x893/rlc-meter-balmer/README.md

# RLC-Meter-balmer
Complex impedance meter capable of measuring impedance in the range 1 mOhm - 10 MW at a frequency of 100 Hz to 250 kHz. Much attention is paid to measurement accuracy. Accuracy of better than 0.5% in the range 10 ohms - 100 ohms at frequencies of 100 Hz - 100 kHz.
