x893/rlc-meter-balmer/circuit/analog3.pdf

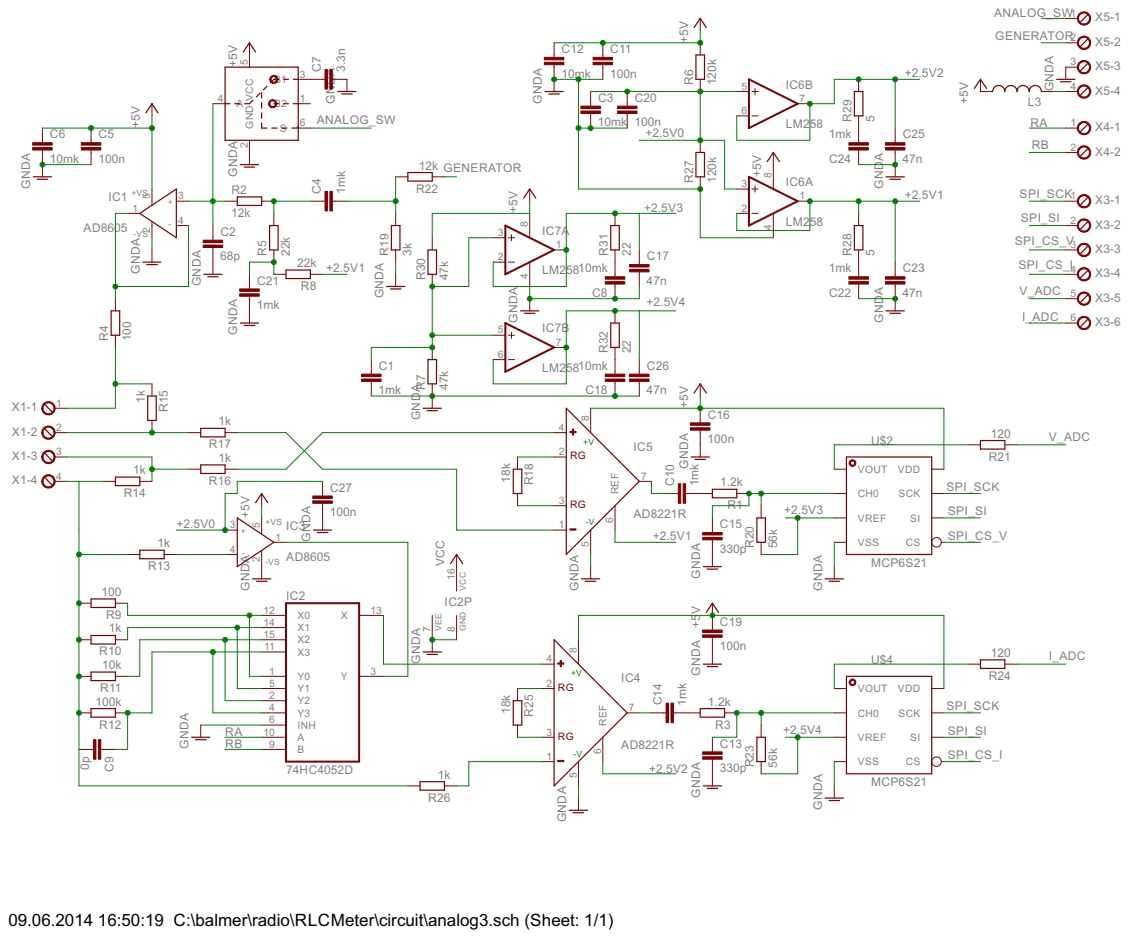
[picture p1: page 1]

09.06.2014 16:50:19 C:\balmer\radio\RLCMeter\circuit\analog3.sch (Sheet: 1/1)
