x893/rlc-meter-balmer/circuit/digital.pdf

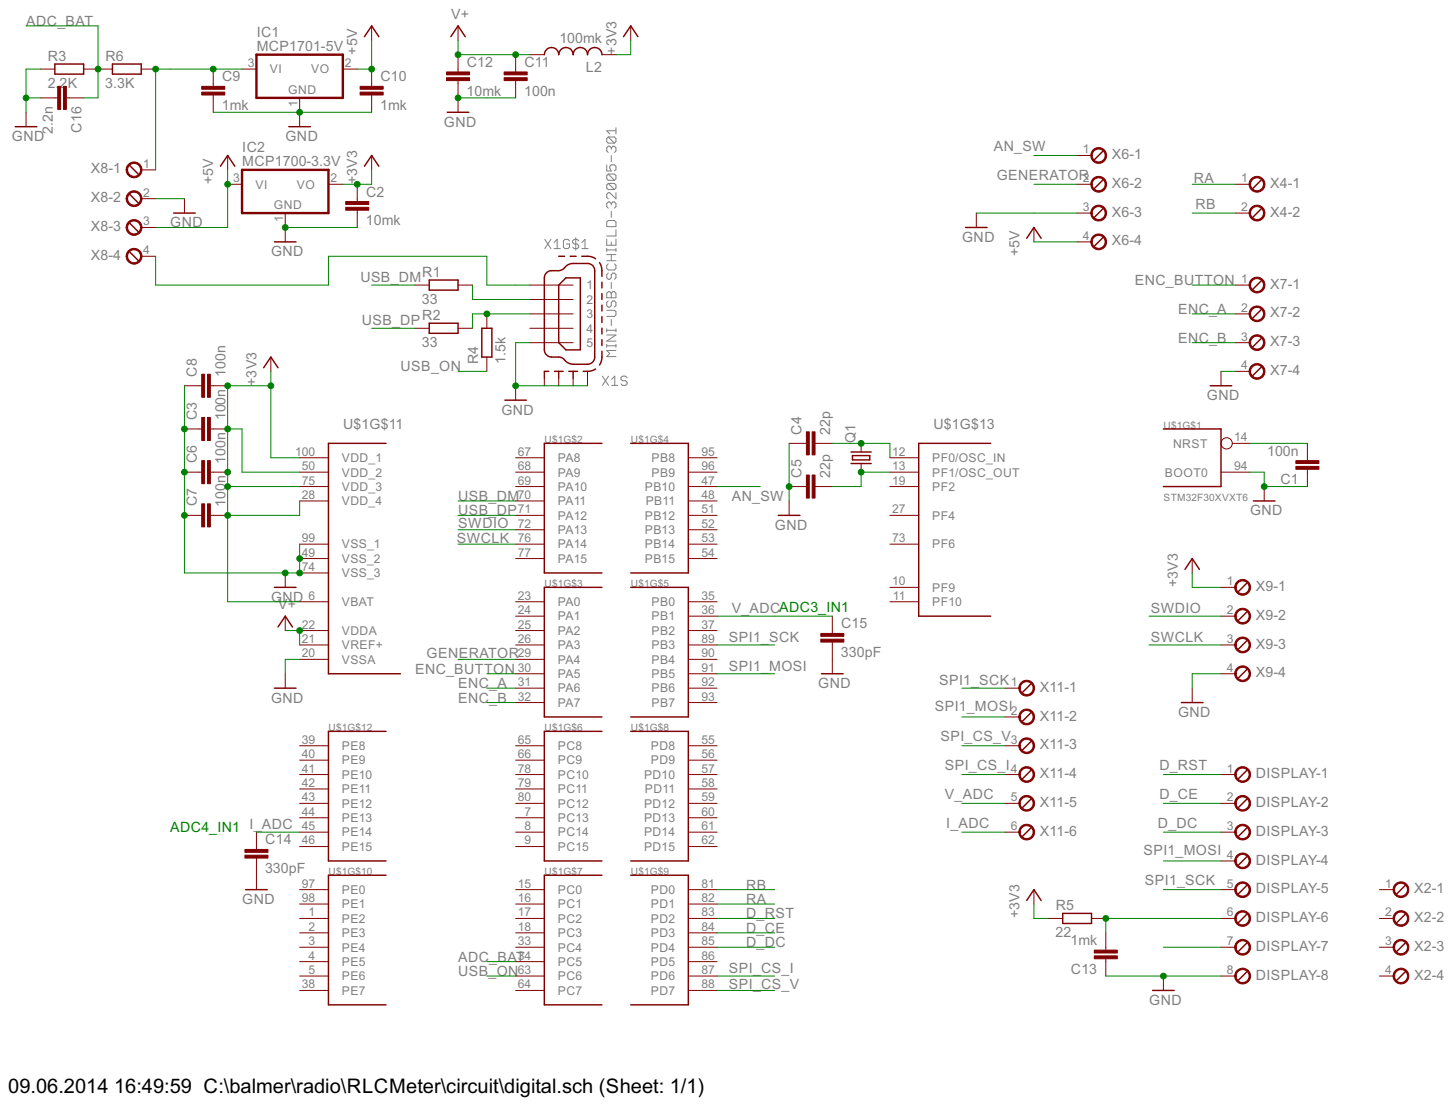
[picture p2: page 1]

09.06.2014 16:49:59 C:\balmer\radio\RLCMeter\circuit\digital.sch (Sheet: 1/1)
