x893/rlc-meter-balmer/circuit/analog3-x893.brd

## EAGLE design circuit/analog3-x893.brd (2015-09-09)

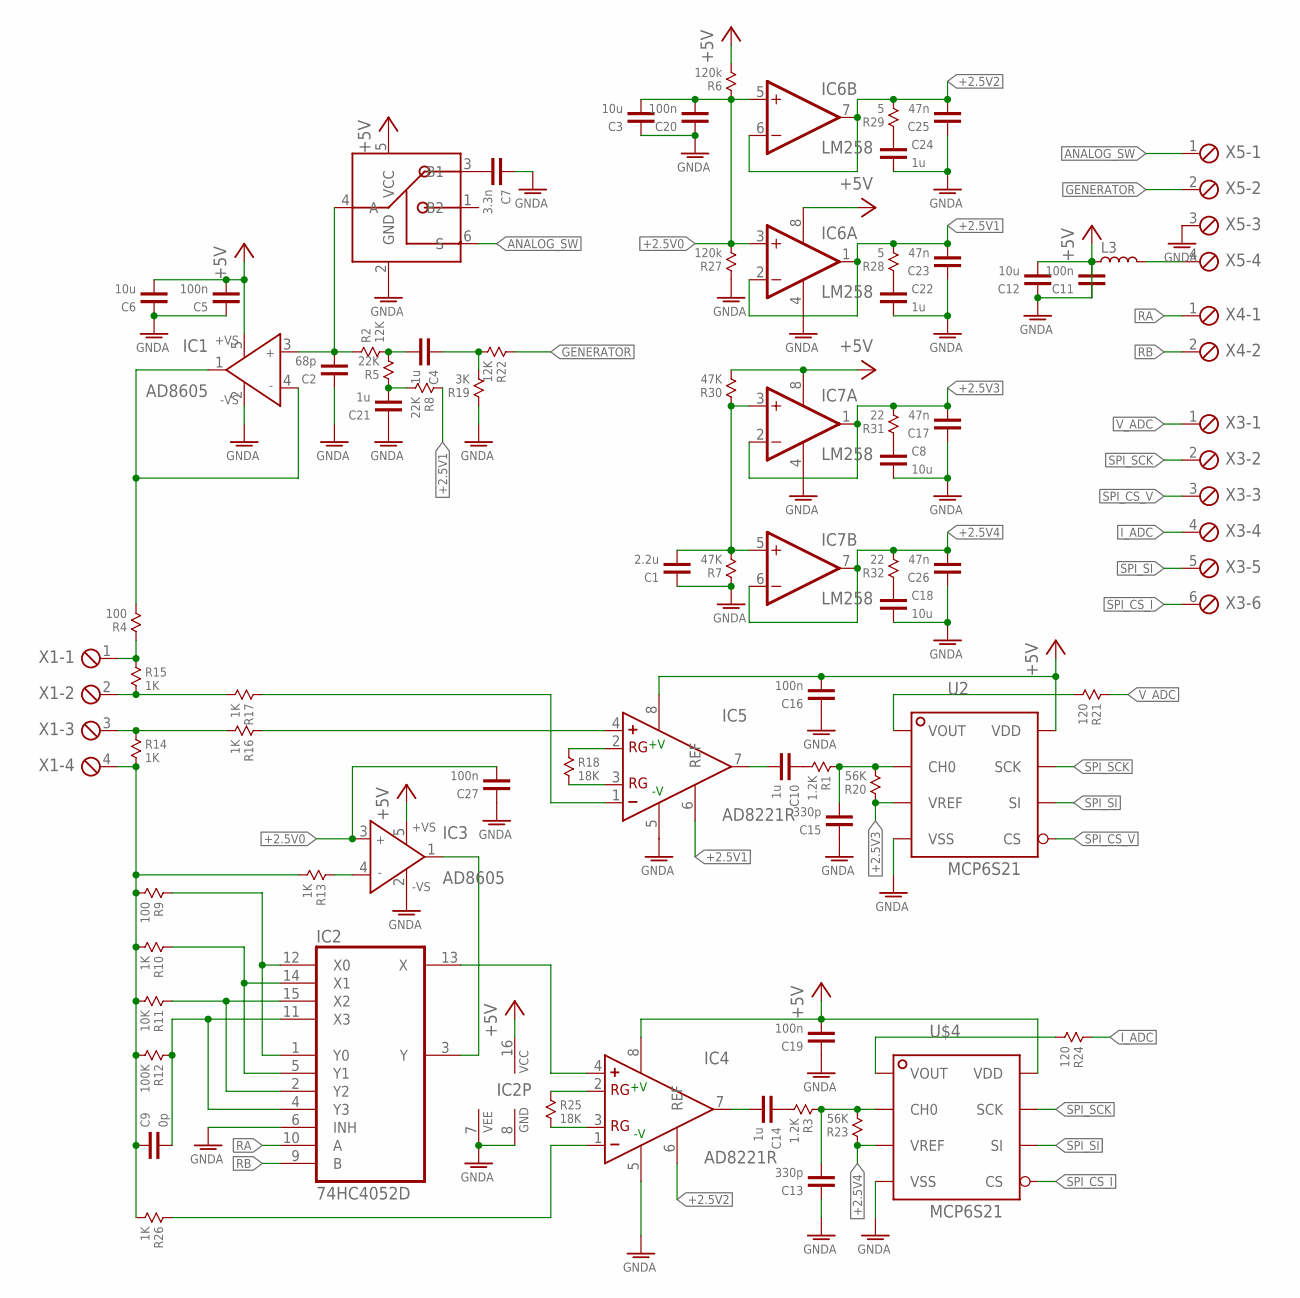
[picture p3: schematic analog3-x893.sch]

Parts:
C1: 2.2u; 0603
C2: 68p; 0603
C3, C6, C8, C12, C18: 10u; 0603
C4, C10, C14, C21, C22, C24: 1u; 0603
C5, C11, C16, C19, C20, C27: 100n; 0603
C7: 3.3n; 0603
C9: 0p; 0603
C13, C15: 330p; 0603
C17, C23, C25, C26: 47n; 0603
IC1, IC3: AD8605; SOT23-5
IC2: 74HC4052D; SO16
IC4, IC5: AD8221R; SO8
IC6, IC7: LM258; SO08
L3: INDUCTOR-0603; 0603
R1, R3: 1.2K; 0603
R2, R22: 12K; 0603
R4, R9: 100; 0603
R5, R8: 22K; 0603
R6, R27: 120k; 0603
R7, R30: 47K; 0603
R10, R13, R14, R15, R16, R17, R26: 1K; 0603
R11: 10K; 0603
R12: 100K; 0603
R18, R25: 18K; 0603
R19: 3K; 0603
R20, R23: 56K; 0603
R21, R24: 120; 0603
R28, R29: 5; 0603
R31, R32: 22; 0603
U2: MCP6S21; SO8
U$1: SN74LVC1G3157DBVR; SOT23-6
U$4: MCP6S21; SO8
X1, X5: MPT4; 4POL254
X3: MPT6; 6POL254
X4: MPT2; 2POL254

Connections:
+2.5V0: C3.1, C20.1, C27.1, IC3.3 (IN+), IC6.3 (+IN), IC6.5 (+IN), R6.1, R27.2
+2.5V1: C23.1, IC5.6 (REF), IC6.1 (OUT), IC6.2 (-IN), R8.1, R28.2
+2.5V2: C25.1, IC4.6 (REF), IC6.6 (-IN), IC6.7 (OUT), R29.2
+2.5V3: C17.1, IC7.1 (OUT), IC7.2 (-IN), R20.1, R31.2, U2.3 (VREF)
+2.5V4: C26.1, IC7.6 (-IN), IC7.7 (OUT), R23.1, R32.2, U$4.3 (VREF)
+5V: C5.1, C6.1, C11.1, C12.1, C16.1, C19.1, IC1.5 (+VS), IC2.16 (VCC), IC3.5 (+VS), IC4.8 (+V), IC5.8 (+V), IC6.8 (V+), IC7.8 (V+), L3.1, R6.2, R30.2, U2.8 (VDD), U$1.5 (VCC), U$4.8 (VDD)
ANALOG_SW: U$1.6 (S), X5.1
GENERATOR: R22.1, X5.2
GNDA: C1.2, C2.2, C3.2, C5.2, C6.2, C7.2, C8.1, C11.2, C12.2, C13.2, C15.2, C16.2, C17.2, C18.1, C19.2, C20.2, C21.2, C22.1, C23.2, C24.1, C25.2, C26.2, C27.2, IC1.2 (-VS), IC2.6 (INH), IC2.7 (VEE), IC2.8 (GND), IC3.2 (-VS), IC4.5 (-V), IC5.5 (-V), IC6.4 (V-), IC7.4 (V-), R7.1, R19.1, R27.1, U2.4 (VSS), U$1.2 (GND), U$4.4 (VSS), X5.3
I_ADC: R24.1, X3.4
unnamed: IC5.1 (-), R17.1
unnamed: C2.1, IC1.3 (IN+), R2.1, U$1.4 (A)
unnamed: C4.1, R2.2, R5.2
unnamed: IC1.1 (OUT), IC1.4 (IN-), R4.2
unnamed: L3.2, X5.4
unnamed: C7.1, U$1.3 (B1)
unnamed: IC3.4 (IN-), R13.1
unnamed: IC4.3 (RG), R25.2
unnamed: C21.1, R5.1, R8.2
unnamed: IC2.3 (Y), IC3.1 (OUT)
unnamed: IC2.1 (Y0), IC2.12 (X0), R9.1
unnamed: IC2.5 (Y1), IC2.14 (X1), R10.1
unnamed: IC2.2 (Y2), IC2.15 (X2), R11.1
unnamed: C9.1, IC2.4 (Y3), IC2.11 (X3), R12.1
unnamed: R14.1, R16.2, X1.3
unnamed: R15.2, R17.2, X1.2
unnamed: C9.2, R9.2, R10.2, R11.2, R12.2, R13.2, R14.2, R26.2, X1.4
unnamed: R4.1, R15.1, X1.1
unnamed: C10.1, IC5.7 (OUT)
unnamed: IC4.2 (RG), R25.1
unnamed: IC4.1 (-), R26.1
unnamed: IC5.3 (RG), R18.2
unnamed: IC5.2 (RG), R18.1
unnamed: C13.1, R3.1, R23.2, U$4.2 (CH0)
unnamed: R24.2, U$4.1 (VOUT)
unnamed: C15.1, R1.1, R20.2, U2.2 (CH0)
unnamed: R21.2, U2.1 (VOUT)
unnamed: C14.1, IC4.7 (OUT)
unnamed: IC2.13 (X), IC4.4 (+)
unnamed: C24.2, R29.1
unnamed: IC5.4 (+), R16.1
unnamed: C8.2, R31.1
unnamed: C4.2, R19.2, R22.2
unnamed: C18.2, R32.1
unnamed: C22.2, R28.1
unnamed: C10.2, R1.2
unnamed: C14.2, R3.2
unnamed: C1.1, IC7.3 (+IN), IC7.5 (+IN), R7.2, R30.1
RA: IC2.10 (A), X4.1
RB: IC2.9 (B), X4.2
SPI_CS_I: U$4.5 (CS), X3.6
SPI_CS_V: U2.5 (CS), X3.3
SPI_SCK: U2.7 (SCK), U$4.7 (SCK), X3.2
SPI_SI: U2.6 (SI), U$4.6 (SI), X3.5
V_ADC: R21.1, X3.1

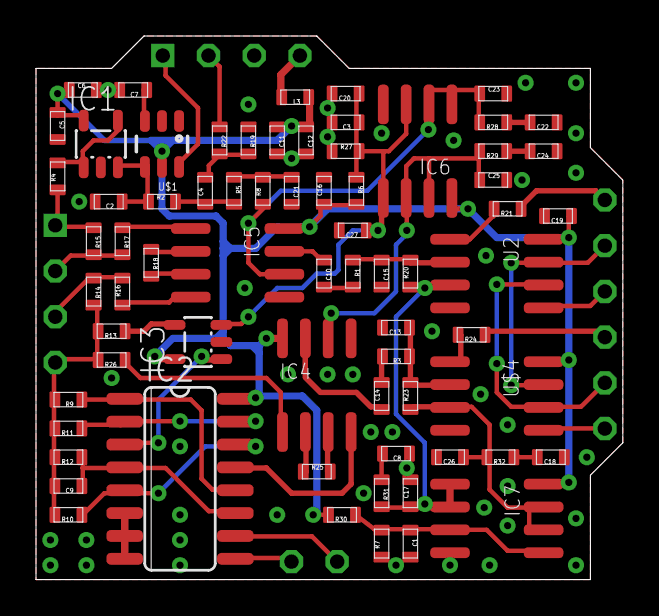
[picture p4: board analog3-x893.brd from above]

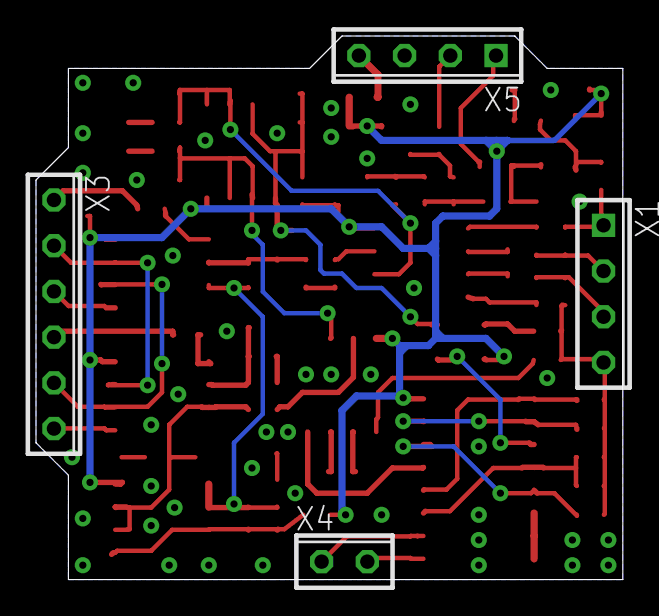
[picture p5: board analog3-x893.brd from below]

Board: 2 copper layers, 32.6 x 30.2 mm, 74 parts (4 on the bottom side), 55 nets.
