x893/rlc-meter-balmer/circuit/digital.brd

## EAGLE design circuit/digital.brd (2014-06-10)

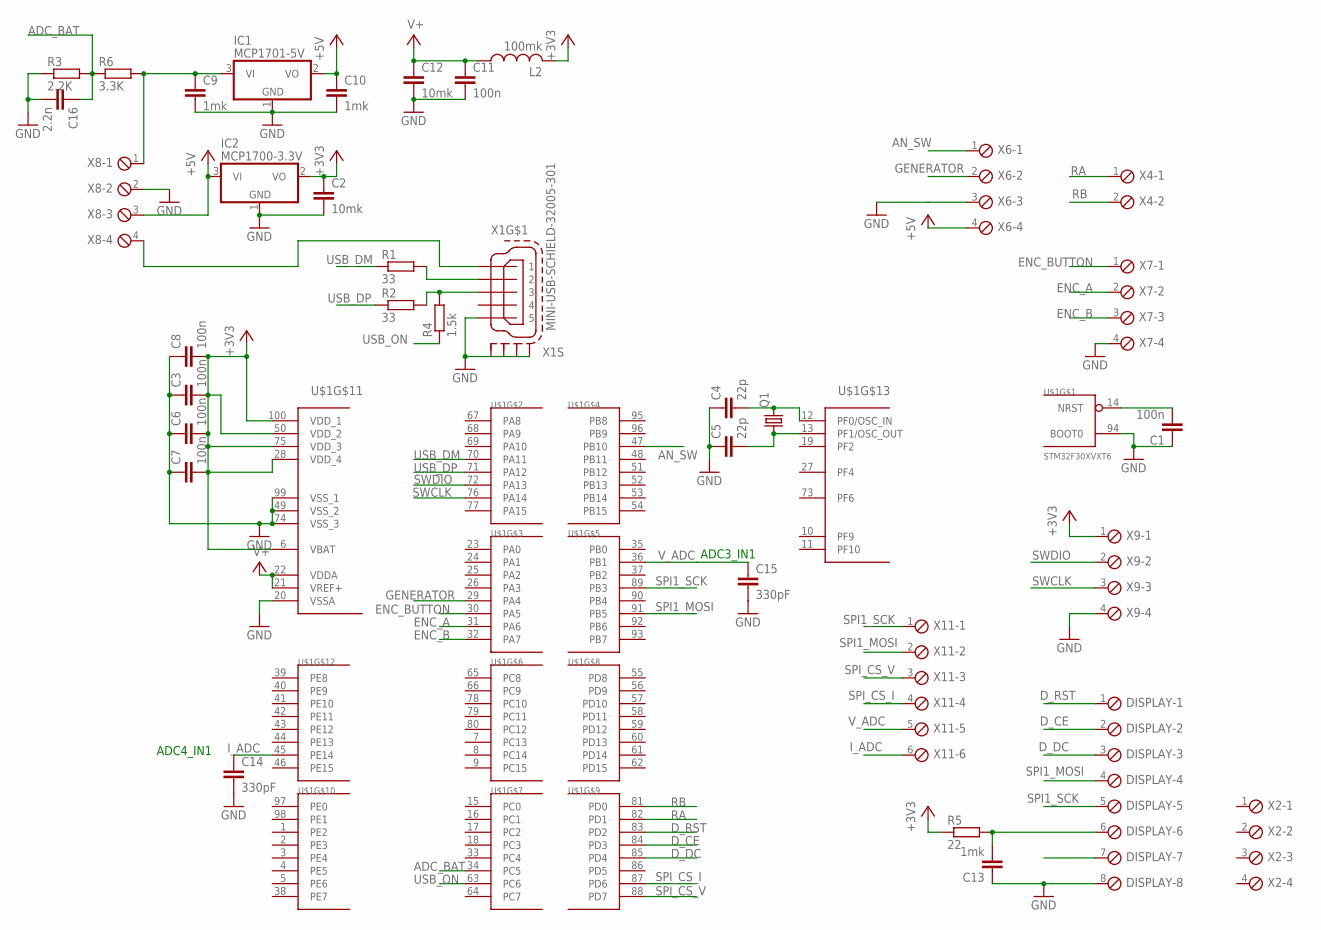
[picture p6: schematic digital.sch]

Parts:
C1, C3, C6, C7, C8, C11: 100n; C0603
C2, C12: 10mk; C0805
C4, C5: 22p; C0805
C9, C10, C13: 1mk; C0603
C14, C15: 330pF; C0805
C16: 2.2n; C0805
DISPLAY: MPT8; 8POL254
IC1: MCP1701-5V; SOT23
IC2: MCP1700-3.3V; SOT23
L2: 100mk; 0204/7
Q1: CRYSTALHC49UP; HC49UP
R1, R2: 33; R0603
R3: 2.2K; R0603
R4: 1.5k; R0603
R5: 22; R0603
R6: 3.3K; R0603
U$1: STM32F30XVXT6; TQFP100
X1: MINI-USB-SCHIELD-32005-301; 32005-301
X2, X6, X7, X8, X9: MPT4; 4POL254
X4: MPT2; 2POL254
X11: MPT6; 6POL254

Connections:
+3V3: C2.1, C3.2, C6.2, C7.2, C8.2, IC2.2 (VO), L2.2, R5.1, U$1.6 (VBAT), U$1.28 (VDD_4), U$1.50 (VDD_2), U$1.75 (VDD_3), U$1.100 (VDD_1), X9.1
+5V: C10.1, IC1.2 (VO), IC2.3 (VI), X6.4, X8.3
ADC_BAT: C16.1, R3.2, R6.1, U$1.34 (PC5)
AN_SW: U$1.47 (PB10), X6.1
D_CE: DISPLAY.2, U$1.84 (PD3)
D_DC: DISPLAY.3, U$1.85 (PD4)
D_RST: DISPLAY.1, U$1.83 (PD2)
ENC_A: U$1.31 (PA6), X7.2
ENC_B: U$1.32 (PA7), X7.3
ENC_BUTTON: U$1.30 (PA5), X7.1
GENERATOR: U$1.29 (PA4), X6.2
GND: C1.1, C2.2, C3.1, C4.1, C5.1, C6.1, C7.1, C8.1, C9.2, C10.2, C11.2, C12.2, C13.1, C14.2, C15.2, C16.2, DISPLAY.8, IC1.1 (GND), IC2.1 (GND), R3.1, U$1.20 (VSSA), U$1.49 (VSS_2), U$1.74 (VSS_3), U$1.94 (BOOT0), U$1.99 (VSS_1), X1.5, X1.M1 (S1), X1.M2 (S2), X1.M3 (S3), X1.M4 (S4), X6.3, X7.4, X8.2, X9.4
I_ADC: C14.1, U$1.45 (PE14), X11.6
unnamed: R1.2, X1.2
unnamed: R2.2, R4.2, X1.3
unnamed: C1.2, U$1.14 (NRST)
unnamed: C4.2, Q1.2, U$1.12 (PF0/OSC_IN)
unnamed: C5.2, Q1.1, U$1.13 (PF1/OSC_OUT)
unnamed: C13.2, DISPLAY.6, R5.2
unnamed: C9.1, IC1.3 (VI), R6.2, X8.1
unnamed: X1.1, X8.4
RA: U$1.82 (PD1), X4.1
RB: U$1.81 (PD0), X4.2
SPI1_MOSI: DISPLAY.4, U$1.91 (PB5), X11.2
SPI1_SCK: DISPLAY.5, U$1.89 (PB3), X11.1
SPI_CS_I: U$1.87 (PD6), X11.4
SPI_CS_V: U$1.88 (PD7), X11.3
SWCLK: U$1.76 (PA14), X9.3
SWDIO: U$1.72 (PA13), X9.2
USB_DM: R1.1, U$1.70 (PA11)
USB_DP: R2.1, U$1.71 (PA12)
USB_ON: R4.1, U$1.63 (PC6)
V+: C11.1, C12.1, L2.1, U$1.21 (VREF+), U$1.22 (VDDA)
V_ADC: C15.1, U$1.36 (PB1), X11.5

Notes on the sheet:
ADC4_IN1
ADC3_IN1

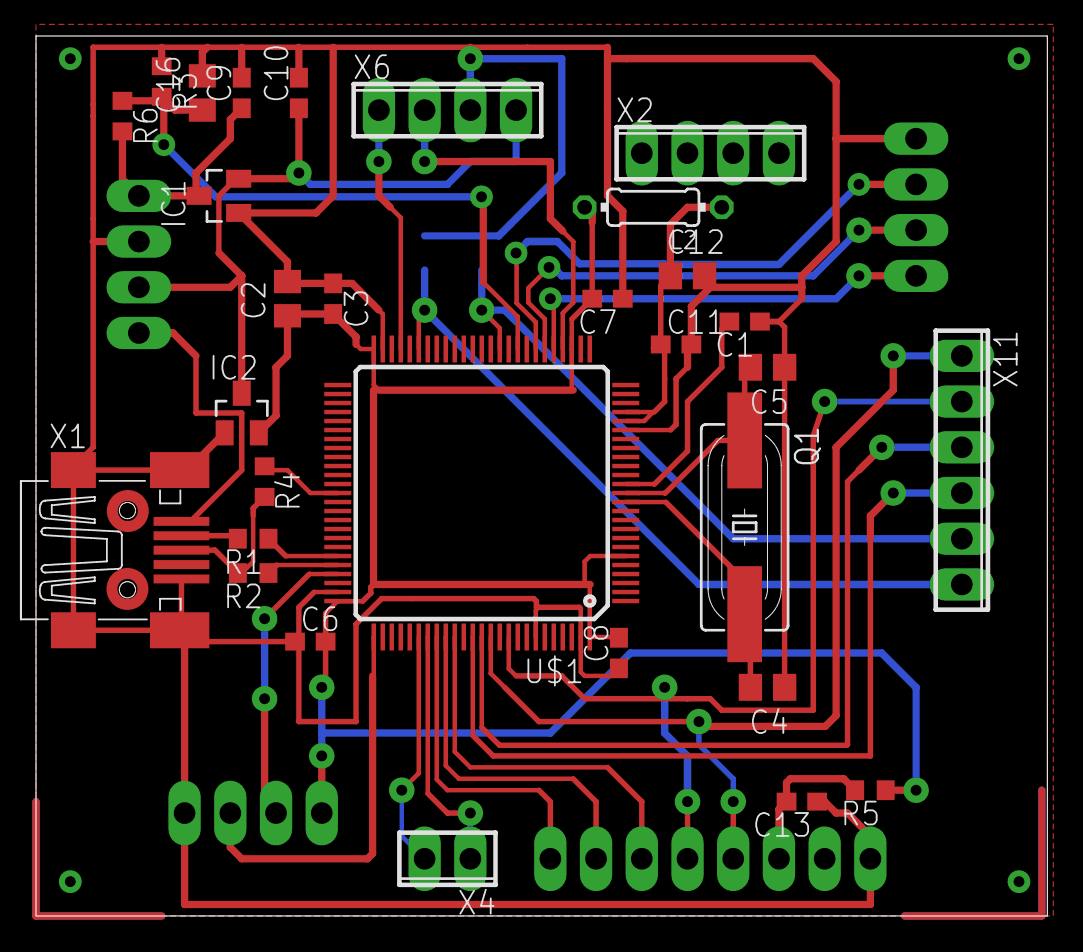
[picture p7: board digital.brd from above]

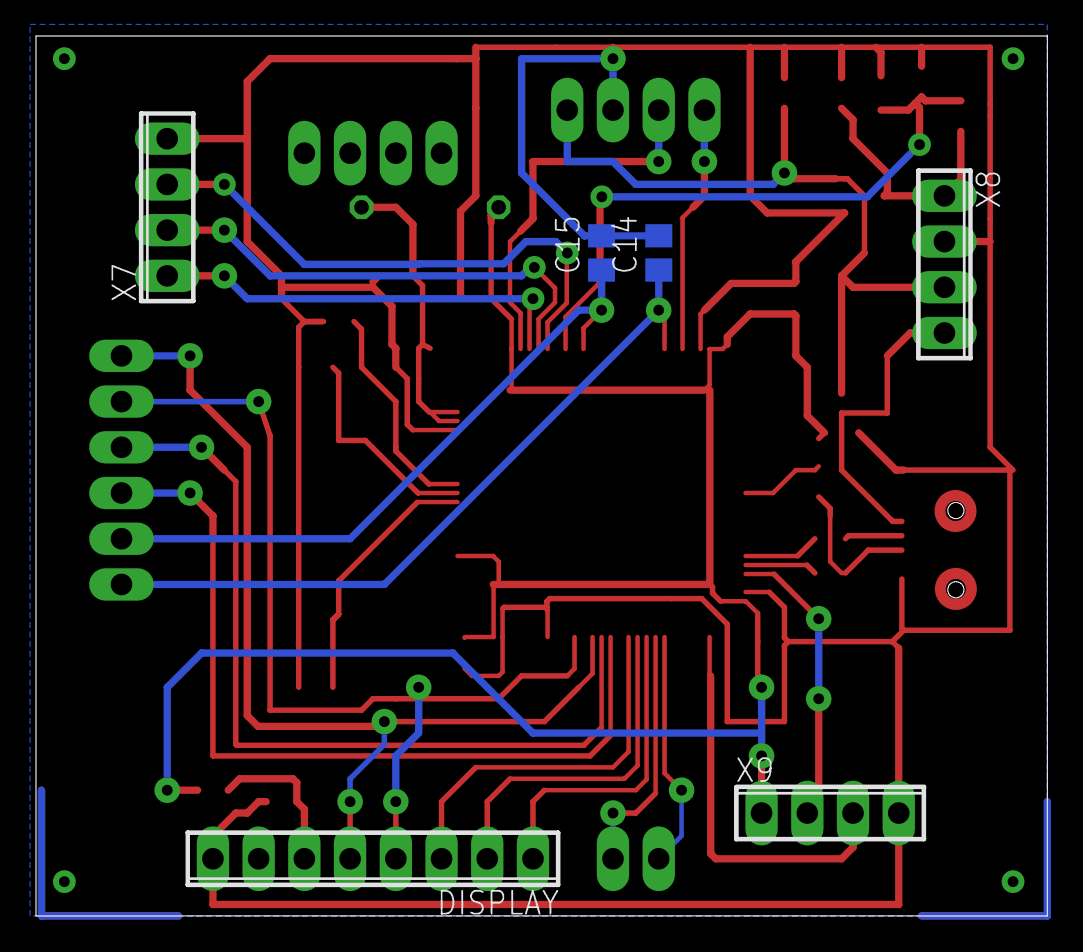
[picture p8: board digital.brd from below]

Board: 2 copper layers, 56.2 x 48.9 mm, 36 parts (6 on the bottom side), 34 nets.
