x893/rlc-meter-balmer/3code/src/pcd8544.c

/*
 *
 * Name         :  pcd8544.c
 *
 * Description  :  This is a driver for the PCD8544 graphic LCD.
 *                 Based on the code written by Sylvain Bissonette
 *                 This driver is buffered in 504 bytes memory be sure
 *                 that your MCU having bigger memory
 *
 * Author       :  Fandi Gunawan <fandigunawan@gmail.com>
 * Website      :  http://fandigunawan.wordpress.com
 *
 * Credit       :  Sylvain Bissonette (2003)
 *
 * License      :  GPL v. 3
 *
 * Compiler     :  WinAVR, GCC for AVR platform
 *                 Tested version :
 *                 - 20070525 (avr-libc 1.4)
 *                 - 20071221 (avr-libc 1.6)
 *                 - 20081225 tested by Jakub Lasinski
 *                 - other version please contact me if you find out it is working
 * Compiler note:  Please be aware of using older/newer version since WinAVR
 *                 is under extensive development. Please compile with parameter -O1
 *
 * History      :
 * Version 0.2.6 (March 14, 2009) additional optimization by Jakub Lasinski
 * + Optimization using Memset and Memcpy
 * + Bug fix and sample program reviewed
 * + Commented <stdio.h>
 * Version 0.2.5 (December 25, 2008) x-mas version :)
 * + Boundary check is added (reported by starlino on Dec 20, 2008)
 * + Return value is added, it will definitely useful for error checking
 * Version 0.2.4 (March 5, 2008)
 * + Multiplier was added to LcdBars to scale the bars
 * Version 0.2.3 (February 29, 2008)
 * + Rolled back LcdFStr function because of serious bug
 * + Stable release
 * Version 0.2.2 (February 27, 2008)
 * + Optimizing LcdFStr function
 * Version 0.2.1 (January 2, 2008)
 * + Clean up codes
 * + All settings were migrated to pcd8544.h
 * + Using _BV() instead of << to make a better readable code
 * Version 0.2 (December 11-14, 2007)
 * + Bug fixed in LcdLine() and LcdStr()
 * + Adding new routine
 *    - LcdFStr()
 *    - LcdSingleBar()
 *    - LcdBars()
 *    - LcdRect()
 *    - LcdImage()
 * + PROGMEM used instead of using.data section
 * Version 0.1 (December 3, 2007)
 * + First stable driver
 *
 * Note         :
 * Font will be displayed this way (16x6)
 * 1 2 3 4 5 6 7 8 9 0 1 2 3 4
 * 2
 * 3
 * 4
 * 5
 * 6
 *
 * Contributor :
 * + Jakub Lasinski

 Convert to ARM code.
 balmer@inbox.ru RLC Meter 303
 2013-2014
 */

#include <stdbool.h>
#include <string.h>
#include "pcd8544.h"
#include "hw_pcd8544.h"

#define LcdSend(d)	HwLcdSend(d)

/*
* Character lookup table code was taken from the work of Sylvain Bissonette
* This table defines the standard ASCII characters in a 5x7 dot format.
*/
const uint8_t FontLookup[][5] =
{
	{ 0x00, 0x00, 0x00, 0x00, 0x00 },   /* space */
	{ 0x00, 0x00, 0x2f, 0x00, 0x00 },   /* ! */
	{ 0x00, 0x07, 0x00, 0x07, 0x00 },   /* " */
	{ 0x14, 0x7f, 0x14, 0x7f, 0x14 },   /* # */
	{ 0x24, 0x2a, 0x7f, 0x2a, 0x12 },   /* $ */
	{ 0x62, 0x64, 0x08, 0x13, 0x23 },   /* % */
	{ 0x36, 0x49, 0x55, 0x22, 0x50 },   /* & */
	{ 0x00, 0x05, 0x03, 0x00, 0x00 },   /* ' */
	{ 0x00, 0x1c, 0x22, 0x41, 0x00 },   /* ( */
	{ 0x00, 0x41, 0x22, 0x1c, 0x00 },   /* ) */
	{ 0x14, 0x08, 0x3E, 0x08, 0x14 },   /* * */
	{ 0x08, 0x08, 0x3E, 0x08, 0x08 },   /* + */
	{ 0x00, 0x00, 0x50, 0x30, 0x00 },   /* , */
	{ 0x10, 0x10, 0x10, 0x10, 0x10 },   /* - */
	{ 0x00, 0x60, 0x60, 0x00, 0x00 },   /* . */
	{ 0x20, 0x10, 0x08, 0x04, 0x02 },   /* / */
	{ 0x3E, 0x51, 0x49, 0x45, 0x3E },   /* 0 */
	{ 0x00, 0x42, 0x7F, 0x40, 0x00 },   /* 1 */
	{ 0x42, 0x61, 0x51, 0x49, 0x46 },   /* 2 */
	{ 0x21, 0x41, 0x45, 0x4B, 0x31 },   /* 3 */
	{ 0x18, 0x14, 0x12, 0x7F, 0x10 },   /* 4 */
	{ 0x27, 0x45, 0x45, 0x45, 0x39 },   /* 5 */
	{ 0x3C, 0x4A, 0x49, 0x49, 0x30 },   /* 6 */
	{ 0x01, 0x71, 0x09, 0x05, 0x03 },   /* 7 */
	{ 0x36, 0x49, 0x49, 0x49, 0x36 },   /* 8 */
	{ 0x06, 0x49, 0x49, 0x29, 0x1E },   /* 9 */
	{ 0x00, 0x36, 0x36, 0x00, 0x00 },   /* : */
	{ 0x00, 0x56, 0x36, 0x00, 0x00 },   /* ; */
	{ 0x08, 0x14, 0x22, 0x41, 0x00 },   /* < */
	{ 0x14, 0x14, 0x14, 0x14, 0x14 },   /* = */
	{ 0x00, 0x41, 0x22, 0x14, 0x08 },   /* > */
	{ 0x02, 0x01, 0x51, 0x09, 0x06 },   /* ? */
	{ 0x32, 0x49, 0x59, 0x51, 0x3E },   /* @ */
	{ 0x7E, 0x11, 0x11, 0x11, 0x7E },   /* A */
	{ 0x7F, 0x49, 0x49, 0x49, 0x36 },   /* B */
	{ 0x3E, 0x41, 0x41, 0x41, 0x22 },   /* C */
	{ 0x7F, 0x41, 0x41, 0x22, 0x1C },   /* D */
	{ 0x7F, 0x49, 0x49, 0x49, 0x41 },   /* E */
	{ 0x7F, 0x09, 0x09, 0x09, 0x01 },   /* F */
	{ 0x3E, 0x41, 0x49, 0x49, 0x7A },   /* G */
	{ 0x7F, 0x08, 0x08, 0x08, 0x7F },   /* H */
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
	{ 0x55, 0x2A, 0x55, 0x2A, 0x55 },   /* "Yen" */
	{ 0x00, 0x41, 0x41, 0x7F, 0x00 },   /* ] */
	{ 0x04, 0x02, 0x01, 0x02, 0x04 },   /* ^ */
	{ 0x40, 0x40, 0x40, 0x40, 0x40 },   /* _ */
	{ 0x00, 0x01, 0x02, 0x04, 0x00 },   /* ' */
	{ 0x20, 0x54, 0x54, 0x54, 0x78 },   /* a */
	{ 0x7F, 0x48, 0x44, 0x44, 0x38 },   /* b */
	{ 0x38, 0x44, 0x44, 0x44, 0x20 },   /* c */
	{ 0x38, 0x44, 0x44, 0x48, 0x7F },   /* d */
	{ 0x38, 0x54, 0x54, 0x54, 0x18 },   /* e */
	{ 0x08, 0x7E, 0x09, 0x01, 0x02 },   /* f */
	{ 0x0C, 0x52, 0x52, 0x52, 0x3E },   /* g */
	{ 0x7F, 0x08, 0x04, 0x04, 0x78 },   /* h */
	{ 0x00, 0x44, 0x7D, 0x40, 0x00 },   /* i */
	{ 0x20, 0x40, 0x44, 0x3D, 0x00 },   /* j */
	{ 0x7F, 0x10, 0x28, 0x44, 0x00 },   /* k */
	{ 0x00, 0x41, 0x7F, 0x40, 0x00 },   /* l */
	{ 0x7C, 0x04, 0x18, 0x04, 0x78 },   /* m */
	{ 0x7C, 0x08, 0x04, 0x04, 0x78 },   /* n */
	{ 0x38, 0x44, 0x44, 0x44, 0x38 },   /* o */
	{ 0x7C, 0x14, 0x14, 0x14, 0x08 },   /* p */
	{ 0x08, 0x14, 0x14, 0x18, 0x7C },   /* q */
	{ 0x7C, 0x08, 0x04, 0x04, 0x08 },   /* r */
	{ 0x48, 0x54, 0x54, 0x54, 0x20 },   /* s */
	{ 0x04, 0x3F, 0x44, 0x40, 0x20 },   /* t */
	{ 0x3C, 0x40, 0x40, 0x20, 0x7C },   /* u */
	{ 0x1C, 0x20, 0x40, 0x20, 0x1C },   /* v */
	{ 0x3C, 0x40, 0x30, 0x40, 0x3C },   /* w */
	{ 0x44, 0x28, 0x10, 0x28, 0x44 },   /* x */
	{ 0x0C, 0x50, 0x50, 0x50, 0x3C },   /* y */
	{ 0x44, 0x64, 0x54, 0x4C, 0x44 },   /* z */
	{ 0x07, 0x05, 0x07, 0x00, 0x00 }    /* { -> GRADUS */
};

#define CHAR_MIN 0x20
#define CHAR_COUNT (sizeof(FontLookup)/sizeof(FontLookup[0]))

/* Cache buffer in SRAM 84*48 bits or 504 bytes */
uint8_t  LcdCache[LCD_CACHE_SIZE];

/* Cache index */
int   LcdCacheIdx;

void InitLight(void);

/*
 * Name         :  LcdInit
 * Description  :  Performs MCU SPI & LCD controller initialization.
 * Argument(s)  :  None.
 * Return value :  None.
 */
void LcdInit(void)
{
	HwLcdInit();
	HwLcdPinRst(1);
	HwLcdPinCE(0);
	DelaySome();

	/* Toggle display reset pin. */
	HwLcdPinRst(0);
	DelaySome();
	HwLcdPinRst(1);
	DelaySome();

	HwLcdPinCE(0); //Enable display controller (active low).
	HwLcdPinDC(0); //Send command
	// 0x21 LCD Extended Commands.
	// 0xC8 Set LCD Vop (Contrast).
	LcdSend(0x21C8);

	// 0x06 Set Temp coefficent.     
	// 0x13 LCD bias mode 1:48.
	LcdSend(0x0613);

	// 0x20 LCD Standard Commands,Horizontal addressing mode
	// 0x0C LCD in normal mode.
	LcdSend(0x200C);

	/* Clear display on first time use */
	//LcdClear();
	//LcdUpdate();
	HwLcdPinCE(1); //Disable display controller.

	InitLight();
}

/*
 * Name         :  LcdContrast
 * Description  :  Set display contrast.
 * Argument(s)  :  contrast -> Contrast value from 0x00 to 0x7F.
 * Return value :  None.
 */
void LcdContrast(uint8_t contrast)
{
	HwLcdPinCE(0); //Enable display controller (active low).
	HwLcdPinDC(0); //Send command
	/* LCD Extended Commands. */
	/* Set LCD contrast level. */
	LcdSend(0x2180 | contrast);

	/* LCD Standard Commands, horizontal addressing mode. */
	LcdSend(0x20);
	HwLcdPinCE(1); //Disable display controller. 
}

/*
 * Name         :  LcdClear
 * Description  :  Clears the display. LcdUpdate must be called next.
 * Argument(s)  :  None.
 * Return value :  None.
 * Note         :  Based on Sylvain Bissonette's code
 */
void LcdClear(void)
{
	memset(LcdCache, 0x00, LCD_CACHE_SIZE);
}

/*
 * Name         :  LcdGotoXYFont
 * Description  :  Sets cursor location to xy location corresponding to basic
 *                 font size.
 * Argument(s)  :  x, y -> Coordinate for new cursor position. Range: 1,1 .. 14,6
 * Return value :  see return value in pcd8544.h
 * Note         :  Based on Sylvain Bissonette's code
 */
uint8_t LcdGotoXYFont(uint8_t x, uint8_t y)
{
	/* Boundary check, slow down the speed but will guarantee this code wont fail */
	/* Version 0.2.5 - Fixed on Dec 25, 2008 (XMAS) */
	if (x > 14)
		return OUT_OF_BORDER;
	if (y > 6)
		return OUT_OF_BORDER;

	/*  Calculate index. It is defined as address within 504 bytes memory */
	LcdCacheIdx = (x - 1) * 6 + (y - 1) * 84;
	return OK;
}

/*
 * Name         :  LcdChr
 * Description  :  Displays a character at current cursor location and
 *                 increment cursor location.
 * Argument(s)  :  size -> Font size. See enum in pcd8544.h.
 *                 ch   -> Character to write.
 * Return value :  see pcd8544.h about return value
 */
uint8_t LcdChr(LcdFontSize size, char chr)
{
	uint8_t i, c;
	uint8_t b1, b2;
	int  tmpIdx;
	uint8_t ch = (uint8_t)chr;

	if ((ch < CHAR_MIN) || (ch >= (CHAR_MIN + CHAR_COUNT)))
	{
		/* Convert to a printable character. */
		ch = 92;
	}

	if (size == FONT_1X)
	{
		for (i = 0; i < 5; i++)
		{
			/* Copy lookup table from Flash ROM to LcdCache */
			LcdCache[LcdCacheIdx++] = (FontLookup[ch - 32][i]) << 1;
		}
	}
	else if (size == FONT_2X)
	{
		tmpIdx = LcdCacheIdx - 84;

		if (tmpIdx < 0) return OUT_OF_BORDER;

		for (i = 0; i < 5; i++)
		{
			/* Copy lookup table from Flash ROM to temporary c */
			c = (FontLookup[ch - 32][i]) << 1;
			/* Enlarge image */
			/* First part */
			b1 = (c & 0x01) * 3;
			b1 |= (c & 0x02) * 6;
			b1 |= (c & 0x04) * 12;
			b1 |= (c & 0x08) * 24;

			c >>= 4;
			/* Second part */
			b2 = (c & 0x01) * 3;
			b2 |= (c & 0x02) * 6;
			b2 |= (c & 0x04) * 12;
			b2 |= (c & 0x08) * 24;

			/* Copy two parts into LcdCache */
			LcdCache[tmpIdx++] = b1;
			LcdCache[tmpIdx++] = b1;
			LcdCache[tmpIdx + 82] = b2;
			LcdCache[tmpIdx + 83] = b2;
		}

		/* Update x cursor position. */
		/* Version 0.2.5 - Possible bug fixed on Dec 25,2008 */
		LcdCacheIdx = (LcdCacheIdx + 11) % LCD_CACHE_SIZE;
	}

	/* Horizontal gap between characters. */
	/* Version 0.2.5 - Possible bug fixed on Dec 25,2008 */
	LcdCache[LcdCacheIdx] = 0x00;
	/* At index number LCD_CACHE_SIZE - 1, wrap to 0 */
	if (LcdCacheIdx == (LCD_CACHE_SIZE - 1))
	{
		LcdCacheIdx = 0;
		return OK_WITH_WRAP;
	}
	/* Otherwise just increment the index */
	LcdCacheIdx++;
	return OK;
}

/*
 * Name         :  LcdStr
 * Description  :  Displays a character at current cursor location and increment
 *                 cursor location according to font size. This function is
 *                 dedicated to print string laid in SRAM
 * Argument(s)  :  size      -> Font size. See enum.
 *                 dataArray -> Array contained string of char to be written
 *                              into cache.
 * Return value :  see return value on pcd8544.h
 */
uint8_t LcdStr(LcdFontSize size, const char* dataArray)
{
	uint8_t tmpIdx = 0;
	uint8_t response;
	char chr;
	while (1)
	{
		chr = dataArray[tmpIdx];
		if (chr == 0)
			break;

		if (size == FONT_2X && chr == '.' && tmpIdx > 0)
			LcdCacheIdx = (LcdCacheIdx - 2) % LCD_CACHE_SIZE;
		/* Send char */
		response = LcdChr(size, dataArray[tmpIdx]);

		if (size == FONT_2X)
		{
			if (chr == '.')
				LcdCacheIdx = (LcdCacheIdx - 5) % LCD_CACHE_SIZE;
		}
		/* Just in case OUT_OF_BORDER occured */
		/* Dont worry if the signal == OK_WITH_WRAP, the string will
		be wrapped to starting point */
		if (response == OUT_OF_BORDER)
			return OUT_OF_BORDER;
		/* Increase index */
		tmpIdx++;
	}
	return OK;
}


/*
 * Name         :  LcdPixel
 * Description  :  Displays a pixel at given absolute (x, y) location.
 * Argument(s)  :  x, y -> Absolute pixel coordinates
 *                 mode -> Off, On or Xor. See enum in pcd8544.h.
 * Return value :  see return value on pcd8544.h
 * Note         :  Based on Sylvain Bissonette's code
 */
uint8_t LcdPixel(uint8_t x, uint8_t y, LcdPixelMode mode)
{
	uint16_t  index;
	uint8_t  offset;
	uint8_t  data;

	/* Prevent from getting out of border */
	if (x > LCD_X_RES) return OUT_OF_BORDER;
	if (y > LCD_Y_RES) return OUT_OF_BORDER;

	/* Recalculating index and offset */
	index = ((y / 8) * 84) + x;
	offset = y - ((y / 8) * 8);

	data = LcdCache[index];

	/* Bit processing */

	/* Clear mode */
	if (mode == PIXEL_OFF)
	{
		data &= (~(0x01 << offset));
	}

	/* On mode */
	else if (mode == PIXEL_ON)
	{
		data |= (0x01 << offset);
	}

	/* Xor mode */
	else if (mode == PIXEL_XOR)
	{
		data ^= (0x01 << offset);
	}

	/* Final result copied to cache */
	LcdCache[index] = data;

	return OK;
}

/*
 * Name         :  LcdLine
 * Description  :  Draws a line between two points on the display.
 * Argument(s)  :  x1, y1 -> Absolute pixel coordinates for line origin.
 *                 x2, y2 -> Absolute pixel coordinates for line end.
 *                 mode   -> Off, On or Xor. See enum in pcd8544.h.
 * Return value :  see return value on pcd8544.h
 */
uint8_t LcdLine(uint8_t x1, uint8_t x2, uint8_t y1, uint8_t y2, LcdPixelMode mode)
{
	int dx, dy, stepx, stepy, fraction;
	uint8_t response;

	/* Calculate differential form */
	/* dy   y2 - y1 */
	/* -- = ------- */
	/* dx   x2 - x1 */

	/* Take differences */
	dy = y2 - y1;
	dx = x2 - x1;

	/* dy is negative */
	if (dy < 0)
	{
		dy = -dy;
		stepy = -1;
	}
	else
	{
		stepy = 1;
	}

	/* dx is negative */
	if (dx < 0)
	{
		dx = -dx;
		stepx = -1;
	}
	else
	{
		stepx = 1;
	}

	dx <<= 1;
	dy <<= 1;

	/* Draw initial position */
	response = LcdPixel(x1, y1, mode);
	if (response)
		return response;

	/* Draw next positions until end */
	if (dx > dy)
	{
		/* Take fraction */
		fraction = dy - (dx >> 1);
		while (x1 != x2)
		{
			if (fraction >= 0)
			{
				y1 += stepy;
				fraction -= dx;
			}
			x1 += stepx;
			fraction += dy;

			/* Draw calculated point */
			response = LcdPixel(x1, y1, mode);
			if (response)
				return response;

		}
	}
	else
	{
		/* Take fraction */
		fraction = dx - (dy >> 1);
		while (y1 != y2)
		{
			if (fraction >= 0)
			{
				x1 += stepx;
				fraction -= dy;
			}
			y1 += stepy;
			fraction += dx;

			/* Draw calculated point */
			response = LcdPixel(x1, y1, mode);
			if (response)
				return response;
		}
	}
	return OK;
}

/*
 * Name         :  LcdSingleBar
 * Description  :  Display single bar.
 * Argument(s)  :  baseX  -> absolute x axis coordinate
 *                 baseY  -> absolute y axis coordinate
 *				   height -> height of bar (in pixel)
 *				   width  -> width of bar (in pixel)
 *				   mode   -> Off, On or Xor. See enum in pcd8544.h.
 * Return value :  see return value on pcd8544.h
 */
uint8_t LcdSingleBar(uint8_t baseX, uint8_t baseY, uint8_t height, uint8_t width, LcdPixelMode mode)
{
	uint8_t tmpIdxX, tmpIdxY, tmp;
	uint8_t response;

	/* Checking border */
	if ((baseX > LCD_X_RES) || (baseY > LCD_Y_RES)) return OUT_OF_BORDER;

	if (height > baseY)
		tmp = 0;
	else
		tmp = baseY - height;

	/* Draw lines */
	for (tmpIdxY = tmp; tmpIdxY < baseY; tmpIdxY++)
	{
		for (tmpIdxX = baseX; tmpIdxX < (baseX + width); tmpIdxX++)
		{
			response = LcdPixel(tmpIdxX, tmpIdxY, mode);
			if (response)
				return response;

		}
	}
	return OK;
}

/*
 * Name         :  LcdBars
 * Description  :  Display multiple bars.
 * Argument(s)  :  data[] -> data which want to be plotted
 *                 numbBars  -> number of bars want to be plotted
 *				   width  -> width of bar (in pixel)
 * Return value :  see return value on pcd8544.h
 * Note         :  Please check EMPTY_SPACE_BARS, BAR_X, BAR_Y in pcd8544.h
 */
uint8_t LcdBars(uint8_t data[], uint8_t numbBars, uint8_t width, uint8_t multiplier)
{
	uint8_t b;
	uint8_t tmpIdx = 0;
	uint8_t response;

	for (b = 0; b < numbBars; b++)
	{
		/* Preventing from out of border (LCD_X_RES) */
		if (tmpIdx > LCD_X_RES) return OUT_OF_BORDER;

		/* Calculate x axis */
		tmpIdx = ((width + EMPTY_SPACE_BARS) * b) + BAR_X;

		/* Draw single bar */
		response = LcdSingleBar(tmpIdx, BAR_Y, data[b] * multiplier, width, PIXEL_ON);
		if (response == OUT_OF_BORDER)
			return response;
	}
	return OK;

}
/*
 * Name         :  LcdRect
 * Description  :  Display a rectangle.
 * Argument(s)  :  x1   -> absolute first x axis coordinate
 *                 y1   -> absolute first y axis coordinate
 *				   x2   -> absolute second x axis coordinate
 *				   y2   -> absolute second y axis coordinate
 *				   mode -> Off, On or Xor. See enum in pcd8544.h.
 * Return value :  see return value on pcd8544.h.
 */
uint8_t LcdRect(uint8_t x1, uint8_t x2, uint8_t y1, uint8_t y2, LcdPixelMode mode)
{
	uint8_t tmpIdxX, tmpIdxY;
	uint8_t response;

	/* Checking border */
	if ((x1 > LCD_X_RES) || (x2 > LCD_X_RES) || (y1 > LCD_Y_RES) || (y2 > LCD_Y_RES))
		/* If out of border then return */
		return OUT_OF_BORDER;

	if ((x2 > x1) && (y2 > y1))
	{
		for (tmpIdxY = y1; tmpIdxY < y2; tmpIdxY++)
		{
			/* Draw line horizontally */
			for (tmpIdxX = x1; tmpIdxX < x2; tmpIdxX++)
			{
				/* Draw a pixel */
				response = LcdPixel(tmpIdxX, tmpIdxY, mode);
				if (response)
					return response;
			}
		}
	}
	return OK;
}
/*
 * Name         :  LcdImage
 * Description  :  Image mode display routine.
 * Argument(s)  :  Address of image in hexes
 * Return value :  None.
 * Example      :  LcdImage(&sample_image_declared_as_array);
 */
void LcdImage(const uint8_t * imageData)
{
	memcpy(LcdCache, imageData, LCD_CACHE_SIZE);
}

/*
 * Name         :  LcdUpdate
 * Description  :  Copies the LCD cache into the device RAM.
 * Argument(s)  :  None.
 * Return value :  None.
 */
void LcdUpdate(void)
{
	uint16_t p;

	HwLcdPinCE(0); // Enable display controller (active low).
	HwLcdPinDC(0); // Send command

	/*  Set base address x=0, y=0 */
	LcdSend(0x8040);

	HwLcdPinDC(1); // Send data
	/*  Serialize the display buffer. */
	for (int i = 0; i < LCD_CACHE_SIZE; i += 2)
	{
		p = ((uint16_t)LcdCache[i]) << 8;
		p |= LcdCache[i + 1];
		LcdSend(p);
	}
	HwLcdPinCE(1); // Disable display controller.
}
