x893/rlc-meter-balmer/3code/inc/calc_rc.h

// balmer@inbox.ru RLC Meter 303
// 2013-2014

#ifndef _CALC_RC_H_
#define _CALC_RC_H_

#include <complex.h>

typedef complex float complexf;

#include "adc.h"
#include "process_measure.h"

void OnCalculate(bool useCorrector);

extern complexf lastZx;
extern bool lastZxFilled;


#endif//_CALC_RC_H_
