x893/rlc-meter-balmer/3code/src/calc_rc.c

// balmer@inbox.ru RLC Meter 303
// 2013-2014

#include <stdio.h>
#include <complex.h>

#include "hw_config.h"
#include <math.h>
#include <stdbool.h>
#include "usb_commands.h"
#include "calc_rc.h"
#include "mcp6s21.h"
#include "lcd_interface.h"
#include "corrector.h"
#include "dac.h"

complexf lastZx = 0;
bool lastZxFilled = false;

void OnCalculate(bool useCorrector)
{
	float gain_V = getGainValueV();
	float gain_I = getGainValueI();
	float resistor = getResistorOm();
	float toVolts = 3.3f / 4095.0f;

	complexf zV = g_data.ch_v.k_sin + g_data.ch_v.k_cos * I;
	complexf zI = g_data.ch_i.k_sin + g_data.ch_i.k_cos * I;
	zV *= toVolts / gain_V;
	zI *= toVolts / gain_I;

	complexf Zx = (zV / zI) * resistor;

	lastZxFilled = true;
	calculatedValues = true;
	lastZx = Zx;

	if (useCorrector)
		Zx = Corrector(Zx);

	Rre = creal(Zx);
	Rim = cimag(Zx);
	printGradus = carg(Zx) * 180.0 / 3.14159f;

	float F = DacFrequency();

	if (isSerial)
	{
		valueIsC = false;
		valueL = cimag(Zx) / (2 * pi*F);

		if (cimag(Zx) < -1e-10f)
		{
			valueIsC = true;
			valueC = -1 / (2 * pi * F * cimag(Zx));
		}
		else
		{
			valueC = 0;
		}
		//если сопротивление маленькое и индуктивность немного отрицательная, то таки считаем что это ошибка калибрации
		if (cabs(Zx) < 1 && valueL<0 && valueL>-20e-9)
			valueIsC = false;
	}
	else
	{//parrallel
		valueIsC = true;
		complexf Yx = 1 / Zx;
		valueC = cimag(Yx) / (2 * pi*F);

		if (cimag(Yx) < -1e-10)
		{
			valueIsC = false;
			valueL = -1 / (2 * pi*F*cimag(Yx));
		}
		else
		{
			valueL = 0;
		}

		//если сопротивление большое и емкость немного отрицательная, то таки считаем что это ошибка калибрации
		if (cabs(Zx) > 1e5f && valueC<0 && valueC>-5e-12)
			valueIsC = true;

		Rre = 1.0f / creal(Yx);
		Rim = 1.0f / cimag(Yx);
	}

}
