x893/rlc-meter-balmer/3demo/src/ili/hw_ili9341.h

#ifndef _HW_PCD8544_H_
#define _HW_PCD8544_H_

//#include "stm32f30x.h"
#include <stdbool.h>
#include <stdint.h>
//LCD Hardware routines

void HwLcdInit();

void HwLcdChangeSpiPrescaler(uint16_t spiPrescaler);
//Подождать несколько милисекунд
void DelaySome();

//Управление пинами 0 - low, 1 - high
void HwLcdPinCE(uint8_t on);
void HwLcdPinDC(uint8_t on);
void HwLcdPinRst(uint8_t on);
void HwLcdPinLed(uint8_t on);
uint8_t HwLcdSend(uint8_t data); //send spi data

#endif//_HW_PCD8544_H_
