x893/rlc-meter-balmer/(commit log)

2013-10-27 - analog to dual ADC STM32F103
    [analog2.sch]
2013-10-27 - ????? ????????? ?????????????? ??? ?????? ????????? , AD8532 ????? ??????? ???????? Input offset voltage.
    [analog.sch, analog2.brd, analog2.sch]
2013-10-27 - AD825, OP07C ?????????? ??? ?????????
    [analog2.sch]
2013-10-29 - SO8
    [analog2.brd]
2013-10-31 - ????????? ??? ???????????? ??? F103 ??????????
    [analog2.brd]
2013-11-03 - DAC 100 khz STM32F107
    [analog2.brd, analog2.sch]
2013-11-05 - systick ?????? ??????? ?????, ?? ??????????? ? USB, ?? ???????? ?? 200 ms - ???????? USB ?? STM32F107 - ??????????????? ??????
2013-11-07 - ????????? ADC ?? ???????
2013-11-09 - ????????? ????????????????? ADC ? DAC
2013-11-19 - ?????? ??????? ???????? ??? ??? LM258 ? ???????? ???????? ??????????
    [analog3.brd, analog3.sch]
2013-11-19 - ?????? ???? Unrouted
    [analog3.brd]
2013-11-24 - ??? ????? LCD ???????
    [digital.brd, digital.sch]
2013-11-24 - ?????? 4 IO ???? ?? ???? ??????, ??? LCD
    [digital.brd, digital.sch]
2013-11-24 - ???? ??????? ??? USB
    [digital.brd]
2013-11-27 - 0.25 ?? ?????? ? STM32
    [digital.brd, digital.sch]
2013-12-10 - ???????? ?? USB
    [digital.brd, digital.sch]
2013-12-10 - ???????? ?????????? ??? STM32F303
2013-12-13 - ???????????? ADC
2013-12-14 - ? continuous ?????? ???????? ????????? ADC
2013-12-14 - ?????????? ?? ??????? 1.2 mhz adc ? ???????? ?? ???????
2013-12-25 - ?????????? ?????????? ????? ??? ????? ??????? ????????? - ?????? ???????????? ??????????????????, ????????? ????????????? ???????? - ?????????? ?????????????? ??????????? ?? +2.5V
    [analog3.brd, analog3.sch]
2013-12-30 - ????? ???, ??? ????? ???????? SPI
    [analog3.brd, analog3.sch]
2014-01-07 - ??????, ??????? ????? ???????? ??????? sin, cos ???????
    [analog3.brd, analog3.sch]
2014-01-15 C2 100 p -> 33 p R30 100 K -> 56 K - ????????????? ?????????????? ?????? ????????
    [analog3.brd, analog3.sch]
2014-02-05 - ?????? ?????? ?????????? ????? - ?????? Hi Lo WaterMark
    [analog.sch, analog2.brd, analog2.sch, digital.brd]
2014-02-05 - ?????????? SPI 8 bit ?? SPI 16 bit - ????????? ???????? ???????? ????? - LcdStr, LcdChr ????????? char ??????
2014-02-08 - ?? ???????? ????? ???????? ?????? ??? Nokia 5110, ?????????? ??? ???????????? ???????, ?????????? ????????? ?????? - ?? ?????????? ????? ???????? ????????? 3.3 nF ???????????, ??? ?????????? ??????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
    [analog3.brd, analog3.sch, digital.brd, digital.sch]
2014-02-08 - ????????? ???????????? ??????????? ??????? ??? ADC ?? ???????? ????? ?????
    [analog3.brd, analog3.sch, digital.brd, digital.sch]
2014-02-08 - ?????????? ???????? ???????? - ???????? RC ??????? ????? ?????? ? ?????? ???????? ???????? - ???????? ????????????? ?????????, ????? ???? ?? ??? ????????? ???????
    [analog3.brd, analog3.sch, digital.brd, digital.sch]
2014-02-11 - ?????????? quadrature encoder
2014-02-12 - ??????????? ????? ???? ????, ????? ?????????? ? 49 ?? ??????
    [analog3.brd, digital.brd, digital.sch]
2014-02-13 - ????? ?????? GND ? GNDA - ???????? ????????? VBAT ??????????
    [digital.brd, digital.sch]
2014-02-13 - Vbat ???? ?????????? ? ???????, ? ?? ? ?????
    [digital.brd, digital.sch]
2014-02-16 - ?????? ?????????? SPI1
    [digital.brd, digital.sch]
2014-02-23 - ??????? ?????. - PC6 USB_ON ?????????? - PB10 AN_SW ??????????
    [analog3.brd, analog3.sch]
2014-03-29 - ?????? open/short ??????????
    [main.py, usb_commands.py]
2014-04-25 - ?????????? Corrector2x ? ??????
    [calc_rc.c, corrector.c, corrector.h, format_print.c, main.c, usb_commands.py, voltage.c]
2014-04-28 - ??????? dev.reset() ???????? ?????? ?????? ? usb ??????? ??????? ? ??????? ?????!
    [usb_commands.py]
2014-05-09 - quadrature encoder code
2014-05-10 - TIM7 50 ms interrupt to button up/down check
2014-05-19 - PE1 - light control pin
2014-06-06 - ?????? ????????? corrector.c - ????????? ???????? ???????????? ???????? ?? ??????????? ?????????? - ?????? ?????????? ????????? ??? ?????? corrector2x
    [corrector.c, corrector.h, jplot.py, main.c, process_measure.c, usb_commands.py, voltage.c]
2014-06-07 - ?????? ?? flash - ??? ????????? ???????? ??? ADC, ???????? ???????? ???? ? ????????
2014-06-09 ????????????? voltage.c -> usb_commands.c
2014-06-09 - add pdf circuit
2014-06-10 - infos
    [analog3.brd, analog3.sch, digital.brd, digital.sch]
2014-06-14 - ???????? ???????? - ?????? ???? printGradus = carg(Zx)...
2014-07-30 - onboard short correction
    [corrector.c, corrector.h, menu.c, process_measure.c]
2014-07-31 - open calibration
2015-09-09 Working commit
    [analog3-x893.brd, analog3-x893.sch]
