x893/rlc-meter-balmer/(notices)

Notices in the files:
3demo/src/ad9958_drv.c:
and/or modify it under the terms of the GNU General Public License as
published by the Free Software Foundation, either version 3 of the License,
or (at your option) any later version.
